SheffieldMLtracking/bee_track_hardware/README.md

# bee_track_hardware
The PCBs and 3d print models etc for the bee tracking system
