SheffieldMLtracking/bee_track_hardware/240625 Freecad formulas box design.rtf

Spreadsheet.Flash_Height * 3 + Spreadsheet.InnerWall_Thickness * 2 + Spreadsheet.TopBottomWall_Thickness * 2
Box height

Spreadsheet.OuterWall_Thickness * 2 + Spreadsheet.Flash_Width * 2 + Spreadsheet.VoltageReg_Width
box width

Spreadsheet.Flash_Depth - Spreadsheet.FrontLid_Thickness + Spreadsheet.HotShoe_Depth
box internal depth (from inside of back wall to front)

Spreadsheet.BackWall_Thickness + Spreadsheet.Flash_Depth - Spreadsheet.FrontLid_Thickness + Spreadsheet.HotShoe_Depth
box depth including back wall

Spreadsheet.BackWall_Thickness + Spreadsheet.Flash_Depth - Spreadsheet.FrontLid_Thickness + Spreadsheet.HotShoe_Depth - 2 * Spreadsheet.FrontPillar_Width - Spreadsheet.BackWall_Thickness
window width

Spreadsheet.True_Flash_Height + Spreadsheet.Flash_Clearance
window height

(Spreadsheet.BackWall_Thickness + Spreadsheet.Flash_Depth - Spreadsheet.FrontLid_Thickness + Spreadsheet.HotShoe_Depth) / 2 - Spreadsheet.FrontPillar_Width
window left edge from centre

(Spreadsheet.True_Flash_Height + Spreadsheet.Flash_Clearance) / 2
middle window top from center

(Spreadsheet.True_Flash_Height + Spreadsheet.Flash_Clearance) / 2 + Spreadsheet.SideWindow_VerticalGapBetweenWindows
top bottom window dist from centre

____________
(Spreadsheet.Flash_Depth - Spreadsheet.FrontLid_Thickness + Spreadsheet.HotShoe_Depth + Spreadsheet.BackWall_Thickness) / 2 - Spreadsheet.FrontPillar_Width / 2
window holes x front

(Spreadsheet.Flash_Depth - Spreadsheet.FrontLid_Thickness + Spreadsheet.HotShoe_Depth + Spreadsheet.BackWall_Thickness) / 2 - Spreadsheet.FrontPillar_Width / 2 - Spreadsheet.BackWall_Thickness
window holes x back

(Spreadsheet.Flash_Height * 3 + Spreadsheet.InnerWall_Thickness * 2) / 2 - 1.5 * Spreadsheet.WindowScrew_Diameter
window holes y top + bottom

___

(Spreadsheet.BackWall_Thickness + Spreadsheet.Flash_Depth - Spreadsheet.FrontLid_Thickness + Spreadsheet.HotShoe_Depth) / 2 - Spreadsheet.BackWall_Thickness + (Spreadsheet.BackWall_Thickness + Spreadsheet.GreenhouseRod_Diameter) / 2
greenhouse rod position

(Spreadsheet.BackWall_Thickness + Spreadsheet.Flash_Depth - Spreadsheet.FrontLid_Thickness + Spreadsheet.HotShoe_Depth) / 2 - Spreadsheet.BackWall_Thickness + (Spreadsheet.BackWall_Thickness / 2 + Spreadsheet.GreenhouseRod_Diameter) / 2 + Spreadsheet.BackWall_Thickness / 2
window screws back holes x

(Spreadsheet.Flash_Height * 3 + Spreadsheet.InnerWall_Thickness * 2 + Spreadsheet.TopBottomWall_Thickness * 2) / 2 - Spreadsheet.TopBottomWall_Thickness - Spreadsheet.CircuitryBox_MountingScrew_Size * 2 - ((Spreadsheet.Flash_Height * 3 + Spreadsheet.InnerWall_Thickness * 2 + Spreadsheet.TopBottomWall_Thickness * 2) / 2 - Spreadsheet.TopBottomWall_Thickness - Spreadsheet.CircuitryBox_MountingScrew_Size * 2 - (Spreadsheet.GreenhouseRod_Offset + Spreadsheet.GreenhouseRod_Diameter)) / 2
window screen back holes y

(Spreadsheet.BackWall_Thickness + Spreadsheet.Flash_Depth - Spreadsheet.FrontLid_Thickness + Spreadsheet.HotShoe_Depth) / 2 - Spreadsheet.BackWall_Thickness + (Spreadsheet.BackWall_Thickness + Spreadsheet.GreenhouseRod_Diameter) / 2
greenhouse rod holes x
______________________
Spreadsheet.BatteryHolder_MountingHole_Width / 2 + 11.5
battery holder front screw x from centre

Spreadsheet.BatteryHolder_MountingHole_Width / 2 + 24
battery holder baCK SCREW X FROM CENTRE

Spreadsheet.BatteryHolder_MountingHole_Height / 2 - 8
BATTERY HOLDER FRONT HOLE Y FROM CENTRE

Spreadsheet.BatteryHolder_MountingHole_Height / 2 - 1
BATTERY HOLDER BACK HOLE Y FROM CENTRE

(Spreadsheet.BackWall_Thickness + Spreadsheet.Flash_Depth - Spreadsheet.FrontLid_Thickness + Spreadsheet.HotShoe_Depth) / 2 - Spreadsheet.LensSlotDepth
lens slot y

(Spreadsheet.OuterWall_Thickness * 2 + Spreadsheet.Flash_Width * 2 + Spreadsheet.VoltageReg_Width) / 2 / 2 - Spreadsheet.LensSlotWidth / 2
lens slot x

__________

top bottom inside wall position

Spreadsheet.GreenhouseRod_Offset - Spreadsheet.GreenhouseRod_Diameter
bottom of rod holder

Spreadsheet.GreenhouseRod_Diameter * 2
height of rod holder

Spreadsheet.GreenhouseRod_Offset + Spreadsheet.GreenhouseRod_Diameter
top of rod holder

_________
(Spreadsheet.Flash_Width * 2 + Spreadsheet.VoltageReg_Width + Spreadsheet.OuterWall_Thickness * 2) / 4 - Spreadsheet.OuterWall_Thickness - Spreadsheet.CircuitryBox_MountingScrew_Size
circuitry box to main box screw holes x
(Spreadsheet.Flash_Height * 3 + Spreadsheet.InnerWall_Thickness * 2 + Spreadsheet.TopBottomWall_Thickness * 2) / 2 - Spreadsheet.TopBottomWall_Thickness - Spreadsheet.CircuitryBox_MountingScrew_Size
circuitry box to main box screw holes y
____________
23.5 / 2 - Spreadsheet.BatteryHolder_LowerPartScrew_Diameter * 1.5 + Spreadsheet.BatteryHolder_LowerPartScrew_Diameter * 1.5
Battholder lower to upper screw hole x

3.5 + Spreadsheet.BatteryHolder_LowerPartScrew_Diameter * 1.5
Battholder lower to upper left screw hole y

33 + Spreadsheet.BatteryHolder_LowerPartScrew_Diameter * 1.5
Battholder lower to upper right screw hole y

__________
(Spreadsheet.OuterWall_Thickness * 2 + Spreadsheet.Flash_Width * 2 + Spreadsheet.VoltageReg_Width) / 2 - Spreadsheet.OuterWall_Thickness - Spreadsheet.CircuitryBox_Lid_Margins
back lid holes x

(Spreadsheet.Flash_Height * 3 + Spreadsheet.InnerWall_Thickness * 2 + Spreadsheet.TopBottomWall_Thickness * 2) / 2 - Spreadsheet.TopBottomWall_Thickness - Spreadsheet.CircuitryBox_Lid_Margins / 2
back lid holes y

((Spreadsheet.OuterWall_Thickness * 2 + Spreadsheet.Flash_Width * 2 + Spreadsheet.VoltageReg_Width) / 2 - Spreadsheet.OuterWall_Thickness) - ((Spreadsheet.OuterWall_Thickness * 2 + Spreadsheet.Flash_Width * 2 + Spreadsheet.VoltageReg_Width) / 4)
circuit box inner wall surface xpos

(Spreadsheet.InnerWall_Thickness * 2 + Spreadsheet.Flash_Height * 3) / 2
circuit box inner wall surface ypos

(Spreadsheet.OuterWall_Thickness * 2 + Spreadsheet.Flash_Width * 2 + Spreadsheet.VoltageReg_Width) / 2 / 2 - Spreadsheet.OuterWall_Thickness - Spreadsheet.CircuitryBox_Lid_Margins
curcuit box lid holes x

(Spreadsheet.Flash_Height * 3 + Spreadsheet.InnerWall_Thickness * 2 + Spreadsheet.TopBottomWall_Thickness * 2) / 2 - Spreadsheet.TopBottomWall_Thickness - Spreadsheet.CircuitryBox_Lid_Margins / 2
circuit box lid holes y

((Spreadsheet.OuterWall_Thickness * 2 + Spreadsheet.Flash_Width * 2 + Spreadsheet.VoltageReg_Width) / 2 - Spreadsheet.OuterWall_Thickness - (Spreadsheet.OuterWall_Thickness * 2 + Spreadsheet.Flash_Width * 2 + Spreadsheet.VoltageReg_Width) / 4 - ((Spreadsheet.OuterWall_Thickness * 2 + Spreadsheet.Flash_Width * 2 + Spreadsheet.VoltageReg_Width) / 2 / 2 - Spreadsheet.OuterWall_Thickness - Spreadsheet.CircuitryBox_Lid_Margins)) * 2
cbox pad for lid nut inset width

((Spreadsheet.InnerWall_Thickness * 2 + Spreadsheet.Flash_Height * 3) / 2 - ((Spreadsheet.Flash_Height * 3 + Spreadsheet.InnerWall_Thickness * 2 + Spreadsheet.TopBottomWall_Thickness * 2) / 2 - Spreadsheet.TopBottomWall_Thickness - Spreadsheet.CircuitryBox_Lid_Margins / 2)) * 2
cbox pad for lid ut inset height

_________
(Spreadsheet.OuterWall_Thickness * 2 + Spreadsheet.Flash_Width * 2 + Spreadsheet.VoltageReg_Width) / 4
cbox box centre from datum centre x

(Spreadsheet.OuterWall_Thickness * 2 + Spreadsheet.Flash_Width * 2 + Spreadsheet.VoltageReg_Width) / 2 - Spreadsheet.OuterWall_Thickness - Spreadsheet.CircuitryBox_Lid_Margins
cbox back curved cut out width

(Spreadsheet.InnerWall_Thickness * 2 + Spreadsheet.Flash_Height * 3) / 2 - Spreadsheet.CircuitryBox_Lid_Margins
cbox back curved cut out top edge fromn centree= of datum y

Spreadsheet.InnerWall_Thickness * 2 + Spreadsheet.Flash_Height * 3 - Spreadsheet.CircuitryBox_Lid_Margins * 2
cbox back curved cutout height

((Spreadsheet.OuterWall_Thickness * 2 + Spreadsheet.Flash_Width * 2 + Spreadsheet.VoltageReg_Width) / 4) + ((Spreadsheet.Flash_Width * 2 + Spreadsheet.VoltageReg_Width + Spreadsheet.OuterWall_Thickness * 2) / 4 - Spreadsheet.OuterWall_Thickness - Spreadsheet.CircuitryBox_MountingScrew_Size)

Spreadsheet.CircuitryBox_Depth / 2 - Spreadsheet.CircuitryBox_Wall_Thickness * 2
CBOX VENT X

Spreadsheet.CircuitryBox_Depth - Spreadsheet.CircuitryBox_Wall_Thickness * 4
cbox vent width

(Spreadsheet.VentHeight + Spreadsheet.VentSeparation) * Spreadsheet.VentYConverter
cbox y dist between tops opf vents
