SheffieldMLtracking/bee_track_hardware/components.md

## Camera
(need 1 or 2 per unit)
<https://shop.scorpion.vision/products/3-2mp-1-1-8-imx265-gige-monochrome-camera-1>
Either greyscale or both greyscale & colour.
Stock: ordered 10 colour; 15 greyscale.

## Lens
(need 1 or 2 per unit)
Stock: ordered 25 6mm.

## Hirose Connector [done - TODO!]
(need 1/2 per unit)
Hirose 6 Pin to 6 Pin Power Cable for Basler CCD AVT Industrial Camera(Straight-Straight, 1M) [ HR10A-7P-6S ]
<https://www.amazon.co.uk/dp/B07YCBNQH2?psc=1&ref=ppx_yo2ov_dt_b_product_details>
Stock: ordered 1 cable (2 systems). TODO Order more!!

## Ethernet cable [done]
(need 1 to 3 per unit)
Previously <https://www.amazon.co.uk/gp/product/B01LF83EZS/ref=ppx_yo_dt_b_search_asin_title?ie=UTF8&psc=1>
Now: <https://uk.farnell.com/pro-signal/psg03118/cat5-lead-0-2m-black/dp/3498229?st=ethernet%20cable>
Stock: Ordered 5 (check they are suitable). (enough for 5 greyscale units)

## Switch / Splitter [done]
(need 0 or 1 per unit -- only needed if colour camera)
Trying out <https://www.amazon.co.uk/gp/product/B0CR6C4Y4H/ref=ox_sc_act_title_1?smid=AOI3HFK8F8ZMZ&psc=1>
Stock: Ordered 1. 

## Contact Spring (for batteries) [done]
(need 4 per unit)
<https://uk.farnell.com/harwin/s7091-42r/contact-spring-smt-2-7mm/dp/2211307?st=spring>
Stock: ordered 12 (3 systems) TODO make 20.
Notes: uses a 2M bolt, nuts and washers.

## Wire [skip]
unit will need about 350mm long black/red figure-8-pair-cable
Stock: Available.

## Fake AA Battery Crimps [done]
(need 2xnumber of flashes per unit, so 8-16 per unit)
Will use these at end of battery to make contact.
Crimps list of possible products <https://uk.farnell.com/w/c/connectors/crimp-terminals-solder-terminals-splices/ring-crimp-terminals/prl/results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|m2.5|m3&range=inc-in-stock|exc-obs|inc-in-stock%7Cexc-obs&sort=P_PRICE>
Ordered these: <https://uk.farnell.com/jst-japan-solderless-terminals/lrb-2-5t-m3/crimp-terminal-ring-m3/dp/7356560>
Need a crimp tool (video <https://www.youtube.com/watch?v=bODeHs6InPw>)
Stock: ordered 100 (for 6 units)

## Raspberry Pi [done]
(need 1 per unit)
<https://shop.pimoroni.com/products/raspberry-pi-5?variant=41044580171859>
Stock: Ordered 5 (for 5 units)

## SD-card [done]
(need 1 per unit)
E.g. 256Gb V30 U3.
<https://www.amazon.co.uk/dp/B08XWT6Q9G?psc=1&ref=ppx_yo2ov_dt_b_product_details>
Stock: Ordered 5 (for 5 units)

## Flash
(need 4-8 per unit)
<https://www.lencarta.com/neewer-tt560-speedlite-flash-for-dslr-cameras>
Ordered: In progress, ordering 50 (for 6 units)

## 12V to 5V Buck Converter [done]
Need 2-4 per unit.
<https://www.amazon.co.uk/dp/B09PTTVXV2>
Ordered: 16. (for 4 units)

## <st>UBEC Skip</st>
<st>For example <https://www.ebay.co.uk/itm/295852158570></st>
Will just use the buck converter.

## Rocker Switches [skip]
(need 2 per unit)
<https://www.amazon.co.uk/dp/B0825W4GGH?ref_=pe_27063361_487360311_302_E_DDE_dt_1>
Ordered: Already have a few?

## Bolt For Tripod
To Do

## More Nuts and Bolts
To Do

## External Power Supply Regulator
Order 6 of these <https://www.amazon.co.uk/dp/B0823DB3W3?psc=1&smid=AFNZSIWHYJJRZ&ref_=chk_typ_imgToDp>.

## External Power Socket
Ordered 15.
<https://www.amazon.co.uk/dp/B0CH7WX85X>

## Field Trial External Batteries
To Do

## 3.5mm right-angle connectors
Ordered these <https://www.ebay.co.uk/itm/183758840967> (12 ordered = 24 connectors, 6 needed per unit, so 4 units).

## Washers for hotshoes [done]
This might not be the design afterall!
20mm outside, M4.
zinc plated steel
<https://www.bolts.co.uk/m4-x-20mm-repair-penny-washer-bzp-pack-of-500-p-FWRMZP04020/>
