SheffieldMLtracking/bee_track_hardware/PCB/power/BOM_PCBWay.xlsx

 |  |  | xxxx xxxx xxxxx xxPCS BOM (Sample Bill of Materials)
Item # | *Designator | *Qty | Manufacturer | *Mfg Part # | Description / Value | *Package/Footprint | Type | Your Instructions / Notes
1 | J1,J2,J3,J4,J5,J6,J7 | 7 | CAMDENBOSS | CTB5202/4 | Standard Terminal Block, Wire to Board, CTB5202, 4 Contacts, 5 mm, Terminal Block, PCB, PCB Mount | 5mm pitch, 4 pins | thru-hole | Please place with holes facing OUTWARDS. | https://uk.farnell.com/camdenboss/ctb5202-4/terminal-block-wire-to-brd-4pos/dp/1717003
