SheffieldMLtracking/bee_track_hardware/PCB/pi_hat/PCBWay_BOM.xlsx

 |  |  | xxxx xxxx xxxxx xxPCS BOM (Sample Bill of Materials)
Item # | *Designator | *Qty | Manufacturer | *Mfg Part # | Description / Value | *Package/Footprint | Type | Your Instructions / Notes
1 | C1 | 1 | MURATA | GRM155R61E105KA12J | SMD Multilayer Ceramic Capacitor 1uF | 0402 [1005 metric] SMD | SMD |  | https://uk.farnell.com/murata/grm155r61e105ka12j/cap-1uf-25v-mlcc-0402/dp/3790417
2 | C2,C3,C4,C6,C7 | 5 | WALSIN | 0402X104K250CT | SMD Multilayer Ceramic Capacitor 0.1uF | 0402 [1005 metric] SMD | SMD |  | https://uk.farnell.com/walsin/0402x104k250ct/cap-0-1-f-25v-10-x5r-0402/dp/2496811
3 | C5 | 1 | KEMET | EDK106M035A9BAA | SMD Aluminium Electrolytic Capacitor, Radial Can. 10 µF. | SMD | SMD | Positive indicated with + | https://uk.farnell.com/kemet/edk106m035a9baa/cap-10uf-35v-alu-elec-smd/dp/4144058
4 | J1,J2,J4,J5,J6,J7,J8,J9 | 8 | CAMDENBOSS | CTB5202/4 | Standard Terminal Block, Wire to Board, CTB5202, 4 Contacts, 5 mm, Terminal Block, PCB, PCB Mount | 5mm pitch, 4 pins | thru-hole | Please place with holes facing OUTWARDS. | https://uk.farnell.com/camdenboss/ctb5202-4/terminal-block-wire-to-brd-4pos/dp/1717003
5 | J3 | 1 | WURTH ELEKTRONIK | 61304021821 | socket header; 2.54 pitch; 20 x 2 rows. | 40 contacts [20 x 2]; 2.54mm pitch | thru-hole | Symmetric (so orientation doesn’t matter) | https://uk.farnell.com/wurth-elektronik/61304021821/connector-rcpt-40pos-2row-2-54mm/dp/2827916
6 | Q1,Q2,Q3,Q4,Q5,Q6,Q7,Q8 | 8 | Multicomp Pro | BC549C | NPN Transistors | TO-92 | thru-hole | Flat side towards edge of PCB, indicated in silk-screen (collector on left) | https://uk.farnell.com/multicomp/bc549c/transistor-npn-30v-to-92/dp/1574382?ost=1574382
7 | R1,R3,R5 | 3 | Multicomp Pro | MCWR04X3303FTL | SMD Chip Resistor, 330K | 0402 [1005 metric] SMD | SMD |  | https://uk.farnell.com/multicomp/mcwr04x3303ftl/res-330k-1-0-0625w-thick-film/dp/2447158
8 | R2,R4,R6 | 3 | Multicomp Pro | MCWR04X5602FTL | SMD Chip Resistor, 56K | 0402 [1005 metric] SMD | SMD |  | https://uk.farnell.com/multicomp/mcwr04x5602ftl/res-56k-1-0-0625w-thick-film/dp/2447198
9 | R9,R10,R11,R12,R13,R14,R15,R16 | 8 | Multicomp Pro | MCWR04X5600FTL | SMD Chip Resistor, 560R | 0402 [1005 metric] SMD | SMD |  | https://uk.farnell.com/multicomp/mcwr04x5600ftl/res-560r-1-0-0625w-thick-film/dp/2447197
10 | U1,U2 | 2 | NEXPERIA | 74AHC08PW-Q100J | 7408 Quad 2-input AND. | 14 pin TSSOP | SMD | Pin 1 indicated by line by pad, and a circle (bottom right) | https://uk.farnell.com/nexperia/74ahc08pw-q100j/and-gate-aec-q100-2-i-p-40to125deg/dp/3441595
11 | U3 | 1 | MICROCHIP | MCP3008-I/SL | Analogue to Digital Converter, Octal, 10 bit. | 16 pin SOIC | SMD | Pin 1 indicated by line next to pad (top left) | https://uk.farnell.com/microchip/mcp3008-i-sl/10bit-adc-8-ch-spi-smd-soic16/dp/1292241?st=mcp3008
12 | U4 | 1 | MICROCHIP | MCP1541T-I/TT | Voltage Reference (4.096V), MCP1541 | SOT-23-3 | SMD | Pin 1 indicated by line next to pad (top left) | https://uk.farnell.com/microchip/mcp1541t-i-tt/voltage-ref-series-4-096v-sot/dp/1084310?st=mcp1541
 |  |  |  |  |  |  |  | All components placed on top side
