SheffieldMLtracking/bee_track_hardware/FreeCAD design files/Exported Step files for each component/Main body #001 (Right).step

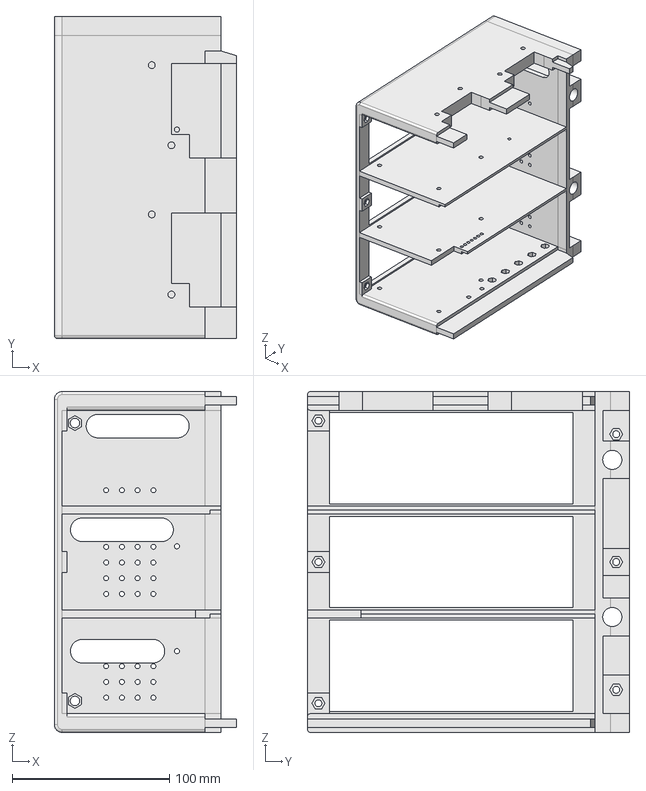
[picture p1: CAD file, 2024-08-01]
FreeCAD design files/Exported Step files for each component/Main body #001 (Right).step
116.0 x 205.0 x 217.0 mm
