SheffieldMLtracking/bee_track_hardware/FreeCAD design files/AABattery (Joe most recent version 2406716).FCStd

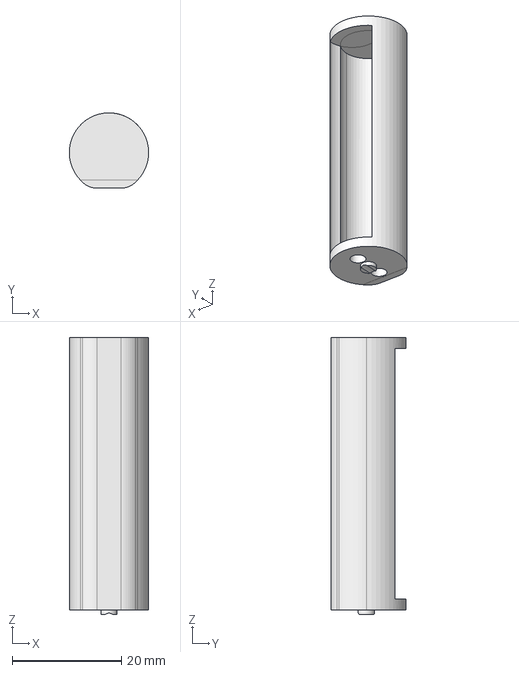
[picture p3: CAD file, 2024-08-01]
FreeCAD design files/AABattery (Joe most recent version 2406716).FCStd
14.5 x 13.7 x 50.6 mm
