SheffieldMLtracking/bee_track_hardware/FreeCAD design files/Exported Step files for each component/Side cover #002 (Left).step

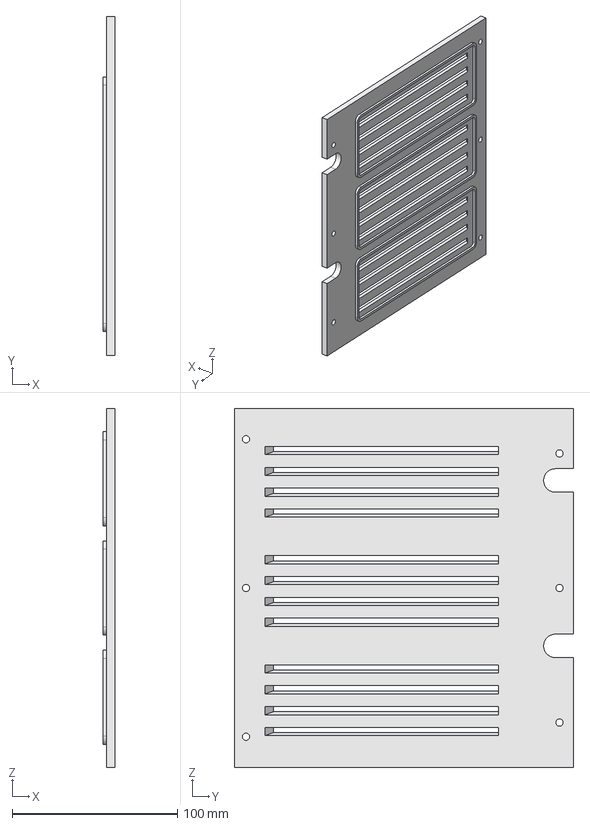
[picture p4: CAD file, 2024-08-01]
FreeCAD design files/Exported Step files for each component/Side cover #002 (Left).step
7.00 x 205.0 x 217.0 mm
