SheffieldMLtracking/bee_track_hardware/markingpots.FCStd

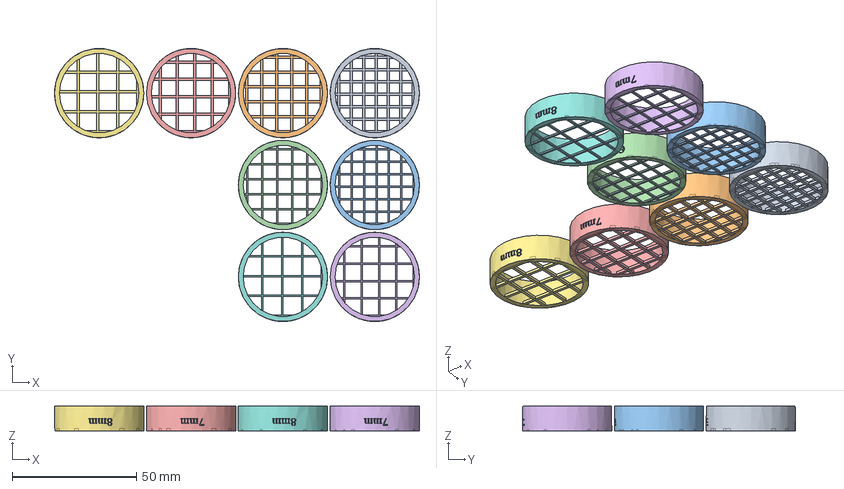
[picture p5: CAD file, 2024-07-18]
markingpots.FCStd
147.0 x 110.0 x 10.0 mm
5mm
6mm
5mm001
6mm001
7mm
7mm001
8mm
8mm001
