SheffieldMLtracking/bee_track_hardware/PCB/pi_hat/BC849CLT1G/3D/BC849CLT1G.stp

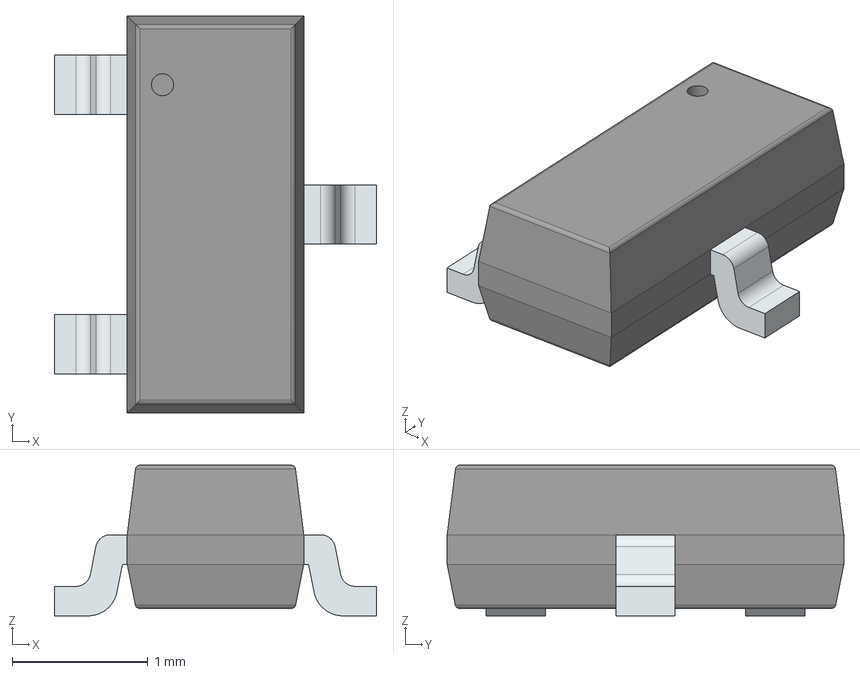
[picture p6: CAD file, 2024-04-17]
PCB/pi_hat/BC849CLT1G/3D/BC849CLT1G.stp
2.37 x 2.92 x 1.11 mm
PinsArrayL
FilletPinR
