SheffieldMLtracking/bee_track_hardware/FreeCAD design files/Exported Step files for each component/Circuit box.step

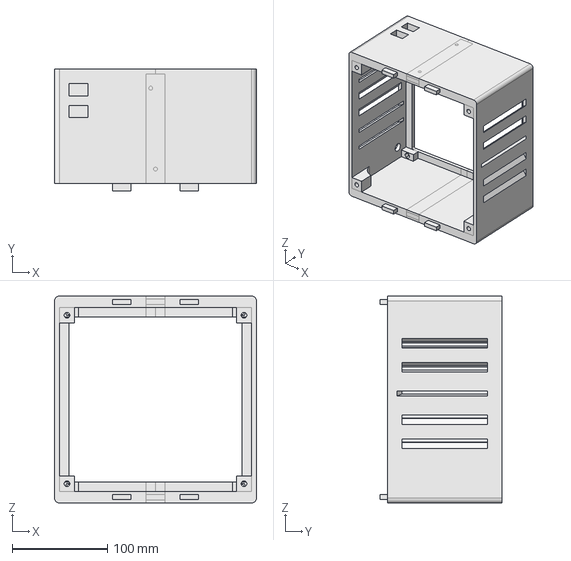
[picture p7: CAD file, 2024-08-01]
FreeCAD design files/Exported Step files for each component/Circuit box.step
212.0 x 127.8 x 217.0 mm
