SheffieldMLtracking/bee_track_hardware/FreeCAD design files/AABattery (Mike version).FCStd

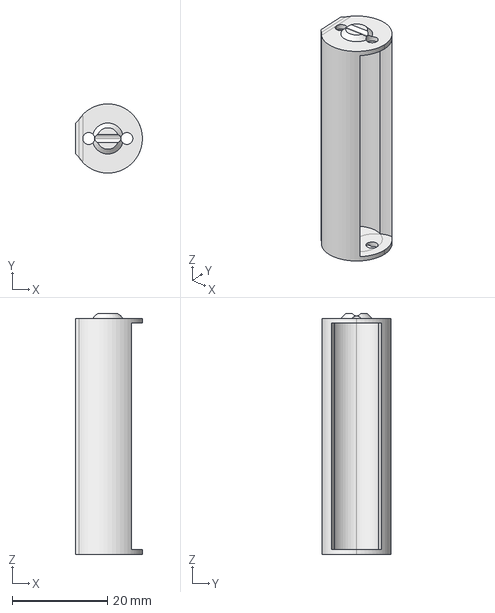
[picture p8: CAD file, 2024-06-29]
FreeCAD design files/AABattery (Mike version).FCStd
14.0 x 14.5 x 50.5 mm
