SheffieldMLtracking/bee_track_hardware/FreeCAD design files/Exported Step files for each component/Tripod mount.step

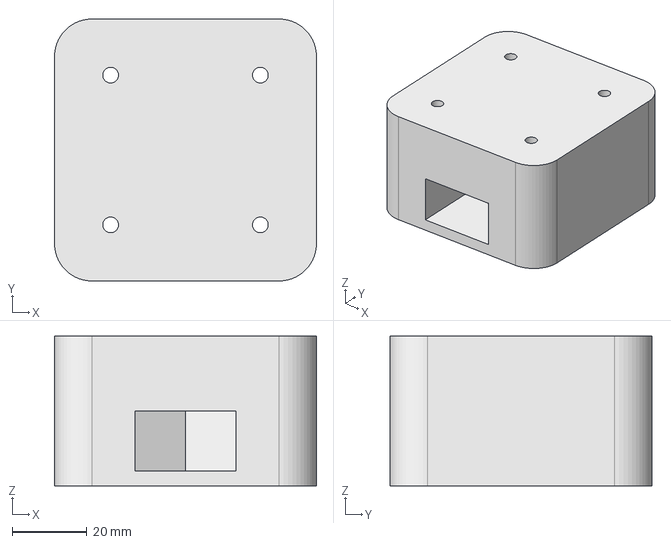
[picture p9: CAD file, 2024-08-01]
FreeCAD design files/Exported Step files for each component/Tripod mount.step
70.0 x 70.0 x 40.0 mm
