SheffieldMLtracking/bee_track_hardware/FreeCAD design files/Exported Step files for each component/Camera mount.step

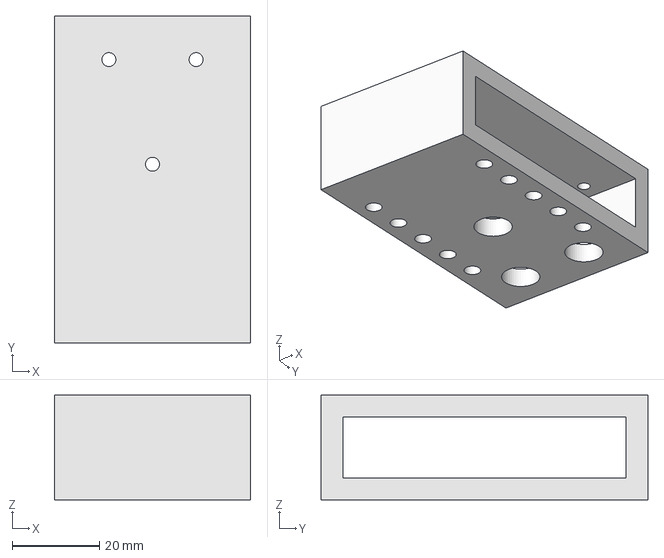
[picture p10: CAD file, 2024-08-01]
FreeCAD design files/Exported Step files for each component/Camera mount.step
45.0 x 75.0 x 24.0 mm
