SheffieldMLtracking/bee_track_hardware/FreeCAD design files/Exported Step files for each component/Back cover.step

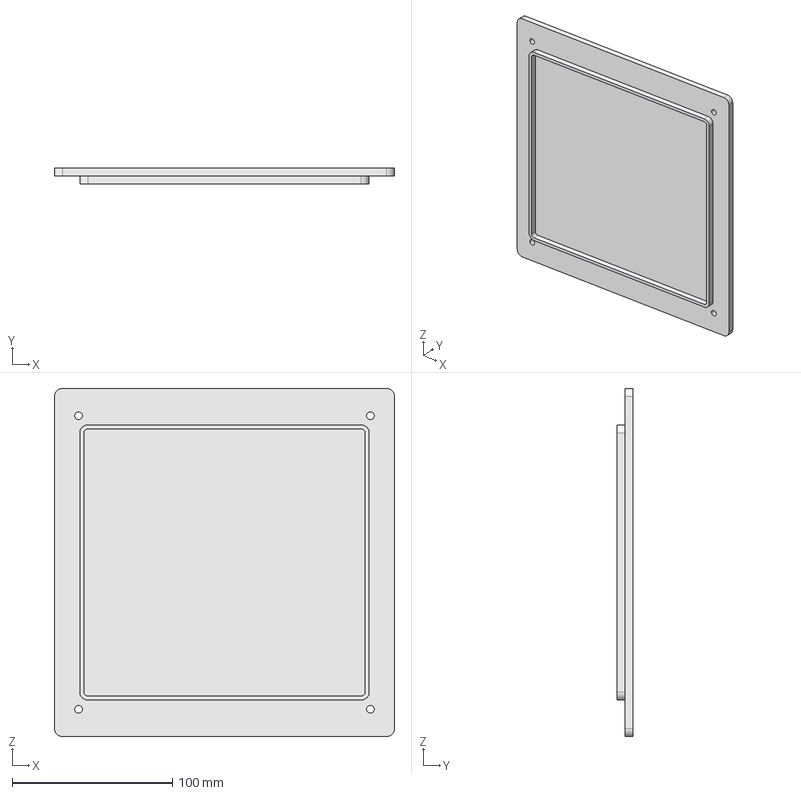
[picture p11: CAD file, 2024-08-01]
FreeCAD design files/Exported Step files for each component/Back cover.step
212.0 x 10.0 x 217.0 mm
