SheffieldMLtracking/bee_track_hardware/FreeCAD design files/Exported Step files for each component/Battery holder #001 (Top).step

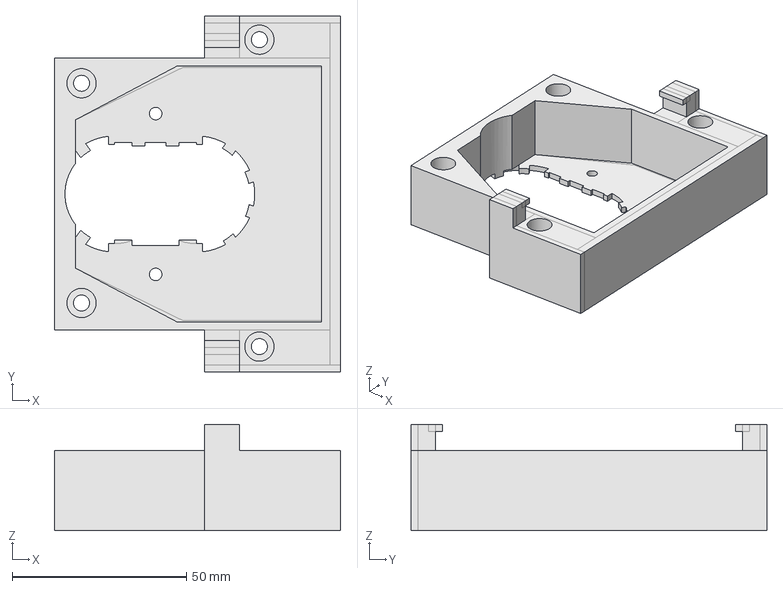
[picture p12: CAD file, 2024-08-01]
FreeCAD design files/Exported Step files for each component/Battery holder #001 (Top).step
82.0 x 102.0 x 30.5 mm
