SheffieldMLtracking/bee_track_hardware/FreeCAD design files/Exported Step files for each component/Battery holder #002 (Bottom).step

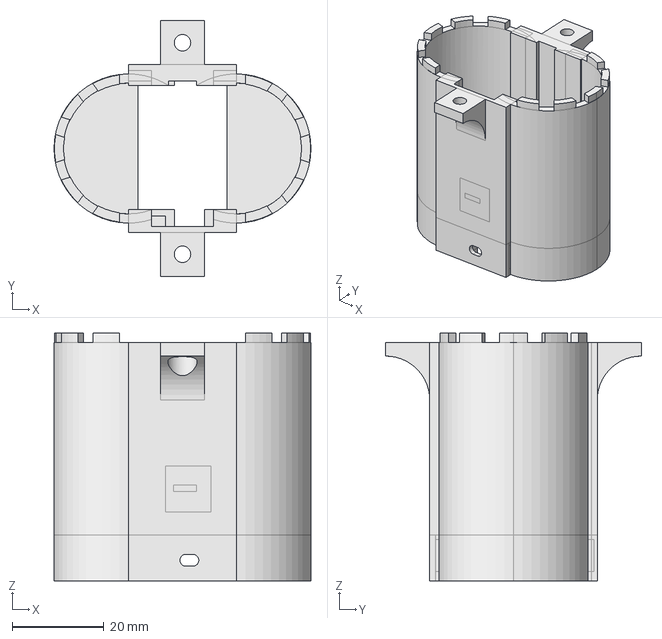
[picture p13: CAD file, 2024-08-01]
FreeCAD design files/Exported Step files for each component/Battery holder #002 (Bottom).step
56.0 x 55.7 x 54.0 mm
