SheffieldMLtracking/bee_track_hardware/OrcaSlicer project files/240716 Main box #002.3mf

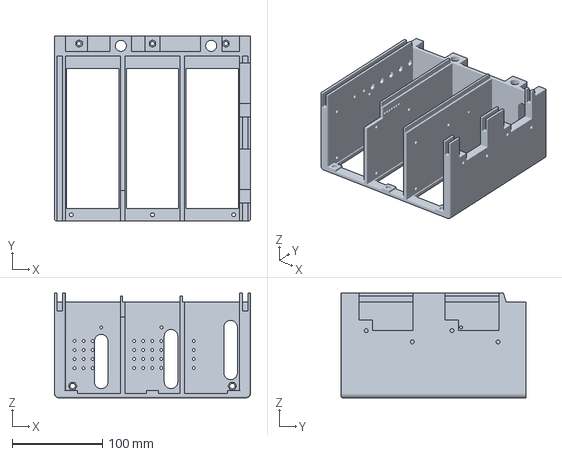
[picture p14: CAD file, 2024-08-01]
OrcaSlicer project files/240716 Main box #002.3mf
217.0 x 205.0 x 116.0 mm
