SheffieldMLtracking/bee_track_hardware/(list of files, cad)

Other CAD files:
FreeCAD design files/RetroreflectorCaseTopology (Joe most recent version 240801).FCStd
FreeCAD design files/Exported Step files for each component/Side cover #001 (Right).step
FreeCAD design files/Exported Step files for each component/AA Battery.step
OrcaSlicer project files/240716 Main box #001.3mf
FreeCAD design files/Exported Step files for each component/Bottom piece (unused).step
OrcaSlicer project files/240712 Back cover.3mf
OrcaSlicer project files/240712 Side cover #001.3mf
OrcaSlicer project files/240716 Battery stuff for half a box.3mf
OrcaSlicer project files/240716 Circuit box.3mf
OrcaSlicer project files/240726 Camera and tripod mounts.3mf
OrcaSlicer project files/240801 All small components for 1 box.3mf
PCB/pi_hat/BC849CLT1G/Allegro/sot96p237x111-3n.psm
PCB/pi_hat/BC849CLT1G/DEHDL/bc849clt1g/chips/chips.prt
