SheffieldMLtracking/bee_track_hardware/(threads)

Thread 1 (2024-05-28):

PCB layout error

lionfish0, 2024-05-28:
The AtoD isn't going to work in "Apr 2024" PCB version:
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
the pinouts are wrong: Got pin 3 and 1 swapped - pin 3 goes to 5V instead of GND. pin 1 goes to GND instead of 5V. pin 2 I think is correctly connected?

The AtoD isn't essential for the project.

Thread 3 (2024-06-29):

AA Fake Batteries

lionfish0, 2024-06-29:
The old batteries are [here](https://github.com/SheffieldMLtracking/bee_track_hardware/blob/main/aabattery.FCStd), but these used a bit of wire twisted through the holes etc. The plan was for the new ones to use [these crimps](https://uk.farnell.com/jst-japan-solderless-terminals/lrb-2-5t-m3/crimp-terminal-ring-m3/dp/7356560) on the batteries - as that means zero soldering.

Two things:

1. I've not designed a new CAD model to accommodate this crimp design.
2. Just to note: Each flash only needs two fake-batteries, and each only needs a contact at ONE end (either the positive end or negative -- see in the old boxes for an example).
