SheffieldMLtracking/bee_track_hardware/PCB/power/pcb.kicad_pcb

## KiCad design PCB/power/pcb.kicad_pcb (2024-04-17)

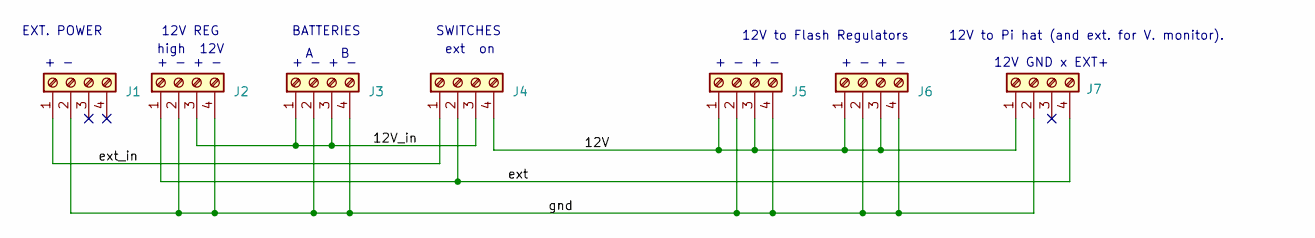
[picture p15: schematic pcb.kicad_sch]

Parts:
J1, J2, J3, J4, J5, J6, J7: Screw_Terminal_01x04; TerminalBlock_RND_205-00278_1x04_P5.00mm_Vertical

Connections:
/12V: J4.4, J5.1, J5.3, J6.1, J6.3, J7.1
/12V_in: J2.3, J3.1, J3.3, J4.3
/ext: J2.1, J4.2, J7.4
/ext_in: J1.1, J4.1
/gnd: J1.2, J2.2, J2.4, J3.2, J3.4, J5.2, J5.4, J6.2, J6.4, J7.2

Notes on the sheet:
high 12V
12V to Flash Regulators
12V REG
+ - + -
BATTERIES
12V to Pi hat (and ext. for V. monitor).
A B
12V GND x EXT+
EXT. POWER
ext on
+ -
SWITCHES

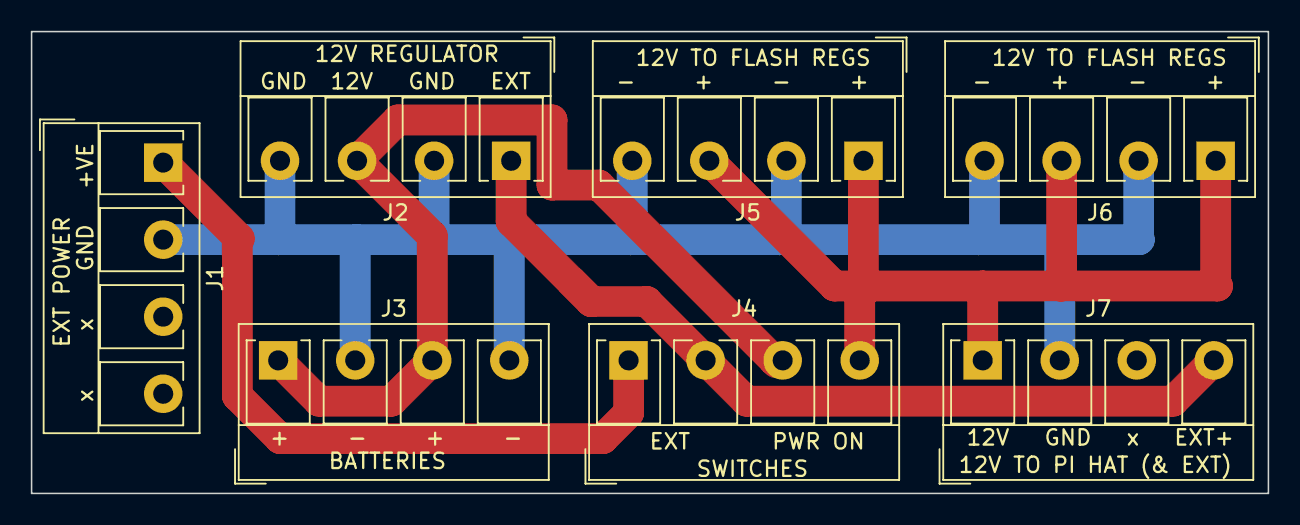
[picture p16: board PCB/power/pcb.kicad_pcb from above]

Board: 2 copper layers, 80.3 x 30.0 mm, 7 parts (0 on the bottom side), 5 nets.
