SheffieldMLtracking/bee_track_hardware/PCB/pi_hat/pcb.kicad_pcb

## KiCad design PCB/pi_hat/pcb.kicad_pcb (2024-04-17)

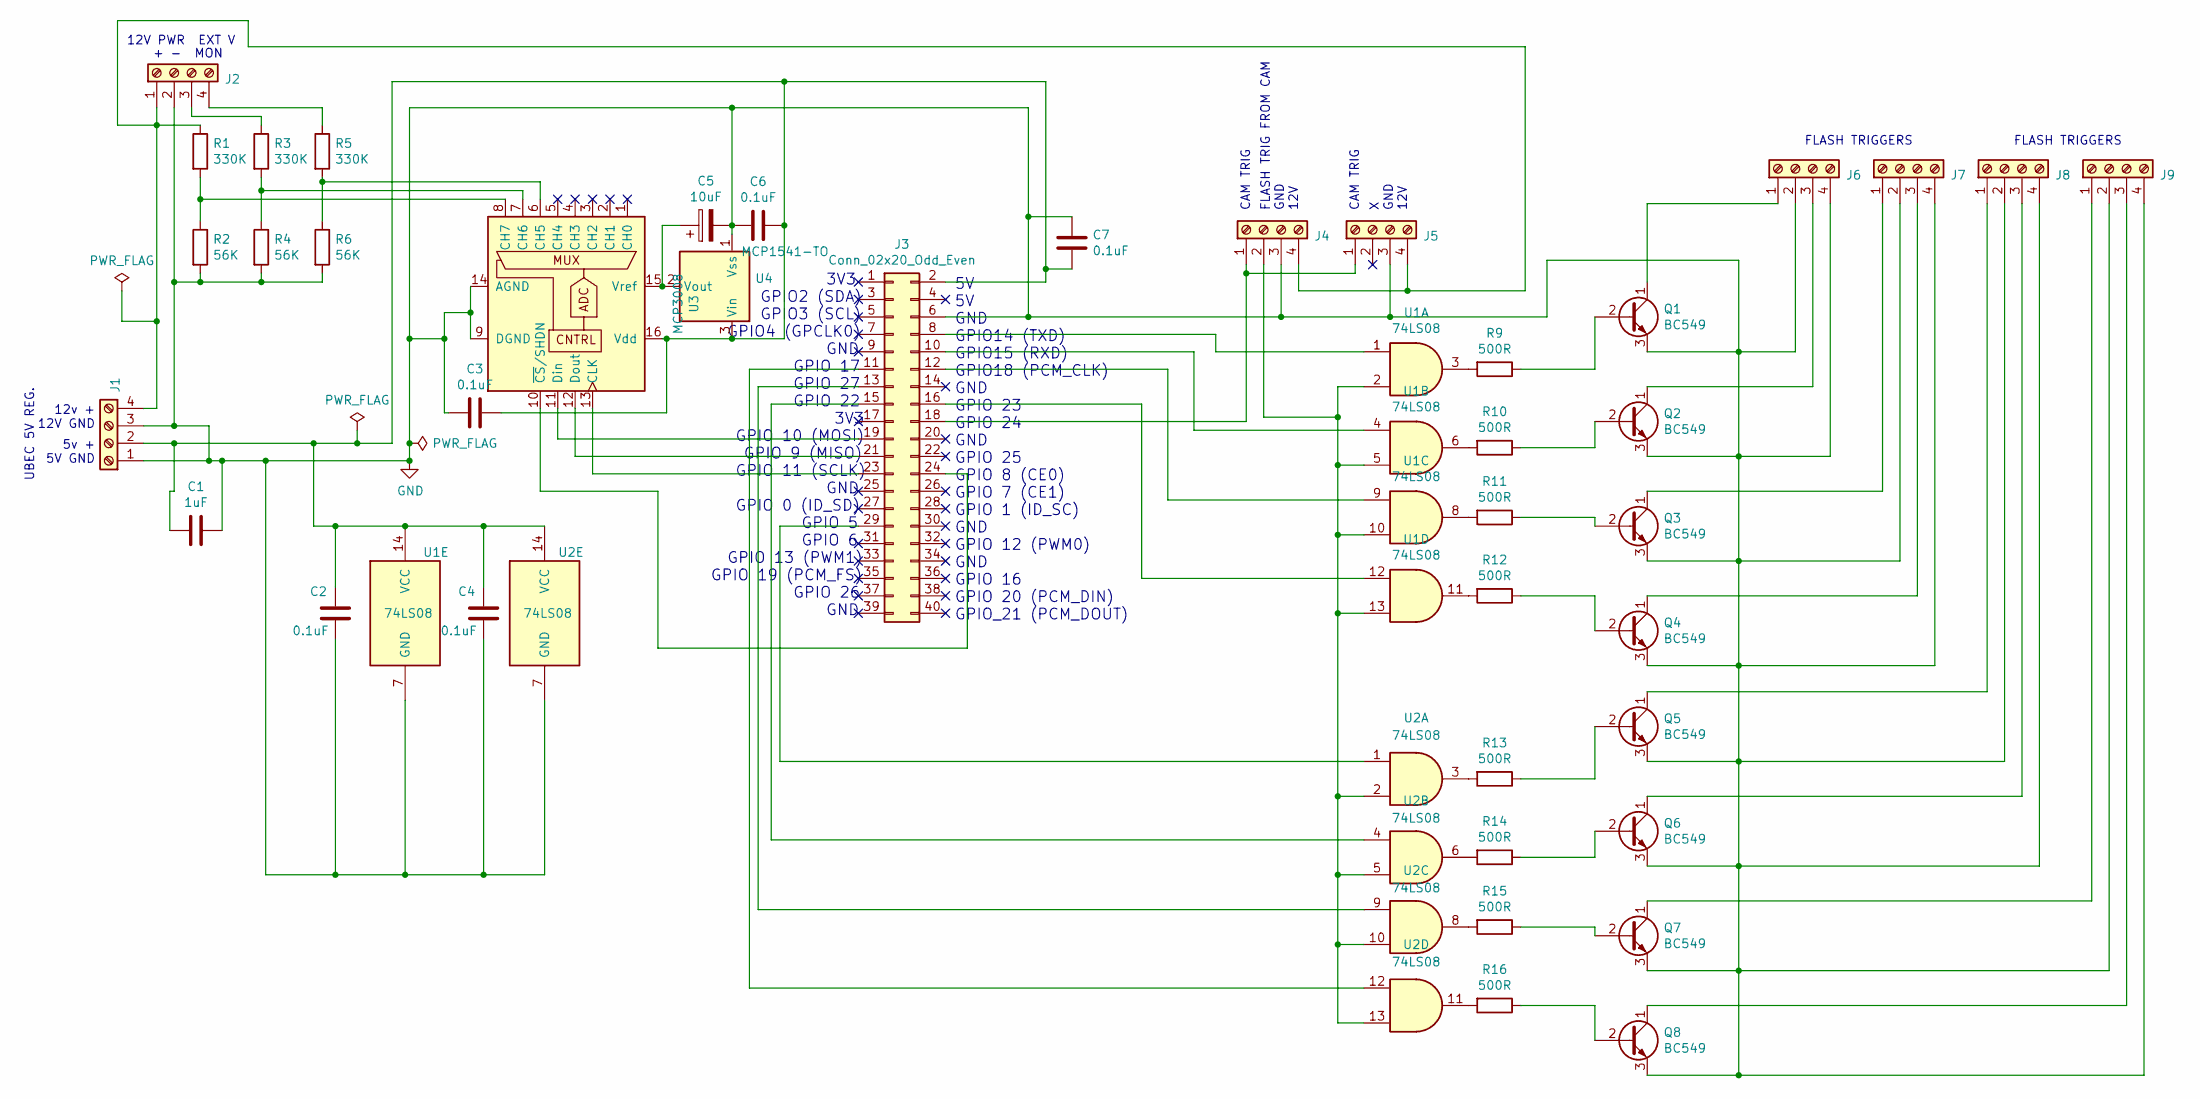
[picture p17: schematic pcb.kicad_sch]

Parts:
C1: 1uF; C_0402_1005Metric
C2, C3, C4, C6, C7: 0.1uF; C_0402_1005Metric
C5: 10uF; CP_Elec_4x5.4
J1, J2, J4, J5, J6, J7, J8, J9: Screw_Terminal_01x04; TerminalBlock_RND_205-00278_1x04_P5.00mm_Vertical
J3: Conn_02x20_Odd_Even; Flipped_IDC
Q1, Q2, Q3, Q4, Q5, Q6, Q7, Q8: BC549; TO-92_Inline
R1, R3, R5: 330K; R_0402_1005Metric
R2, R4, R6: 56K; R_0402_1005Metric
R9, R10, R11, R12, R13, R14, R15, R16: 500R; R_0402_1005Metric
U1, U2: 74LS08; TSSOP-14_4.4x5mm_P0.65mm
U3: MCP3008; SOIC127P600X175-16N
U4: MCP1541-TO; SOT-23-3

Connections:
GND: C1.1, C2.2, C3.2, C4.2, C5.2, C6.2, C7.1, J1.1, J1.3, J2.2, J3.6, J4.3, J5.3, J6.2, J6.4, J7.2, J7.4, J8.2, J8.4, J9.2, J9.4, Q1.3 (E), Q2.3 (E), Q3.3 (E), Q4.3 (E), Q5.3 (E), Q6.3 (E), Q7.3 (E), Q8.3 (E), R2.2, R4.2, R6.2, U1.7 (GND), U2.7 (GND), U3.9 (DGND), U3.14 (AGND), U4.1 (Vss)
unnamed: C1.2, C2.1, C3.1, C4.1, C6.1, C7.2, J1.2, J3.2, U1.14 (VCC), U2.14 (VCC), U3.16 (Vdd), U4.3 (Vin)
unnamed: J1.4, J2.1, J4.4, J5.4, R1.1
unnamed: J2.3, R3.1
unnamed: J2.4, R5.1
unnamed: J3.8, U1.1
unnamed: J3.10, U1.4
unnamed: J3.11, U2.12
unnamed: J3.12, U1.9
unnamed: J3.13, U2.9
unnamed: J3.15, U2.4
unnamed: J3.16, U1.12
unnamed: J3.18, J4.1, J5.1
unnamed: J3.19, U3.11 (Din)
unnamed: J3.21, U3.12 (Dout)
unnamed: J3.23, U3.13 (CLK)
unnamed: J3.24, U3.10 (~CS/SHDN)
unnamed: J3.29, U2.1
unnamed: J4.2, U1.2, U1.5, U1.10, U1.13, U2.2, U2.5, U2.10, U2.13
unnamed: J6.1, Q1.1 (C)
unnamed: J6.3, Q2.1 (C)
unnamed: J7.1, Q3.1 (C)
unnamed: J7.3, Q4.1 (C)
unnamed: J8.1, Q5.1 (C)
unnamed: J8.3, Q6.1 (C)
unnamed: J9.1, Q7.1 (C)
unnamed: J9.3, Q8.1 (C)
unnamed: Q1.2 (B), R9.1
unnamed: Q2.2 (B), R10.1
unnamed: Q3.2 (B), R11.1
unnamed: Q4.2 (B), R12.1
unnamed: Q5.2 (B), R13.1
unnamed: Q6.2 (B), R14.1
unnamed: Q7.2 (B), R15.1
unnamed: Q8.2 (B), R16.1
unnamed: R9.2, U1.3
unnamed: R10.2, U1.6
unnamed: R11.2, U1.8
unnamed: R12.2, U1.11
unnamed: R13.2, U2.3
unnamed: R14.2, U2.6
unnamed: R15.2, U2.8
unnamed: R16.2, U2.11
unnamed: R5.2, R6.1, U3.6 (CH5)
unnamed: R3.2, R4.1, U3.7 (CH6)
unnamed: R1.2, R2.1, U3.8 (CH7)
unnamed: C5.1, U3.15 (Vref), U4.2 (Vout)

Notes on the sheet:
FLASH TRIGGERS
+ - MON
5V 5V GND GPIO14 (TXD) GPIO15 (RXD) GPIO18 (PCM_CLK) GND GPIO 23 GPIO 24 GND GPIO 25 GPIO 8 (CE0) GPIO 7 (CE1) GPIO 1 (ID_SC) GND GPIO 12 (PWM0) GND GPIO 16 GPIO 20 (PCM_DIN) GPIO_21 (PCM_DOUT)
5v + 5V GND
X GND 12V
3V3 GPIO2 (SDA) GPIO3 (SCL) GPIO4 (GPCLK0) GND GPIO 17 GPIO 27 GPIO 22 3V3 GPIO 10 (MOSI) GPIO 9 (MISO) GPIO 11 (SCLK) GND GPIO 0 (ID_SD) GPIO 5 GPIO 6 GPIO 13 (PWM1) GPIO 19 (PCM_FS) GPIO 26 GND
FLASH TRIG FROM CAM GND 12V
UBEC 5V REG.
CAM TRIG
12V PWR EXT V
12v + 12V GND

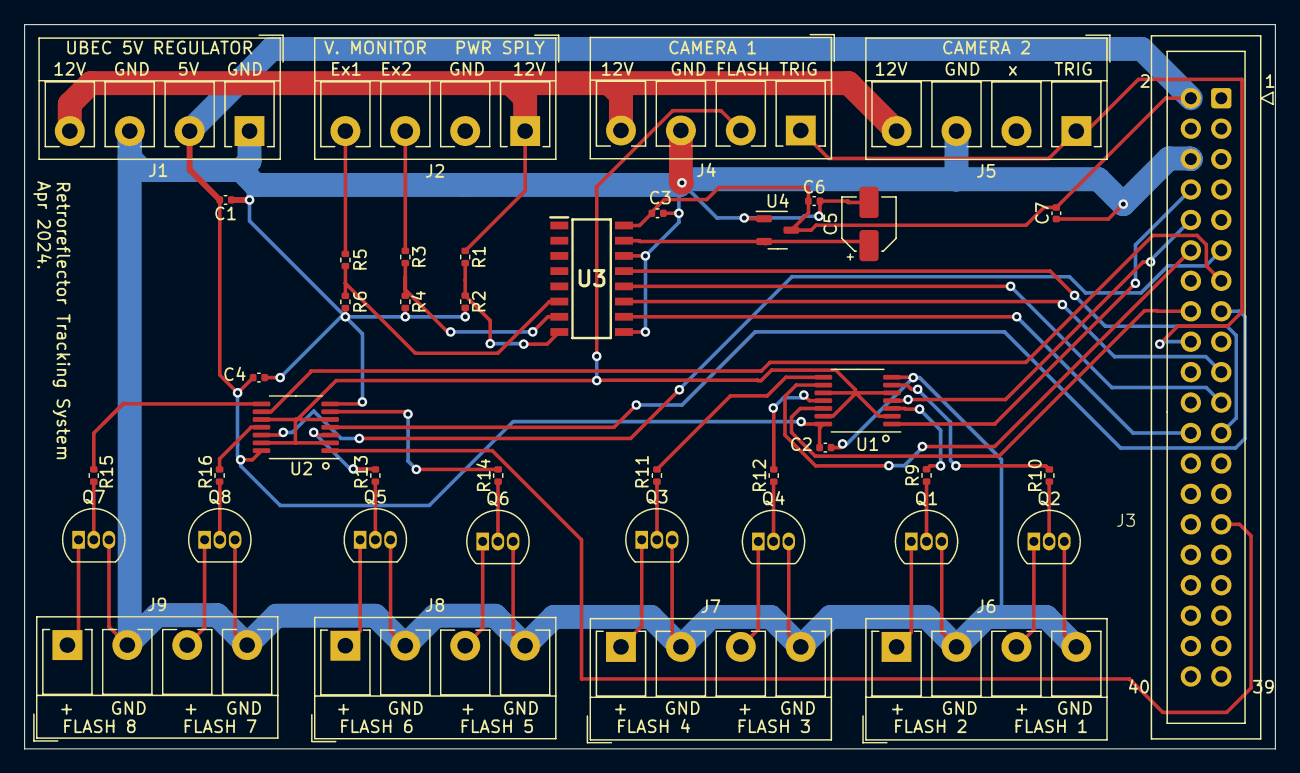
[picture p18: board PCB/pi_hat/pcb.kicad_pcb from above]

Board: 2 copper layers, 104.4 x 60.5 mm, 42 parts (0 on the bottom side), 47 nets.
