SheffieldMLtracking/bee_track_hardware/(commit log)

2024-04-17 Initial commit (send for fab. not tested)
    [BC849CLT1G.stp, EDI2CAP.CFG, PCBWay_BOM.xlsx, chips.prt, pcb.kicad_pcb, pcb.kicad_sch, sot96p237x111-3n.psm]
2024-04-17 Power connections
    [BOM_PCBWay.xlsx, pcb.kicad_pcb, pcb.kicad_sch]
2024-06-18 Dimension fixes and battery holder improvements
2024-06-30 Add files via upload
    Updated 3D files with various changes made by Joe in response to previous test prints 24-30/06/24
2024-08-01 Rename 240712 Back cover.3mf to Orcaslicer project files/240712 Back cover.3mf
    [240712 Back cover.3mf]
2024-08-01 Rename 240712 Side cover #001.3mf to OrcaSlicer project files/240712 Side cover #001.3mf
    [240712 Side cover #001.3mf]
2024-08-01 Rename 240712 Back cover.3mf to 240712 Back cover.3mf
    [240712 Back cover.3mf]
2024-08-01 Rename 240716 Battery stuff for half a box.3mf to OrcaSlicer project files/240716 Battery stuff for half a box.3mf
    [240716 Battery stuff for half a box.3mf]
2024-08-01 Rename 240716 Circuit box.3mf to OrcaSlicer project files/240716 Circuit box.3mf
    [240716 Circuit box.3mf]
2024-08-01 Rename 240716 Main box #001.3mf to OrcaSlicer project files/240716 Main box #001.3mf
    [240716 Main box #001.3mf]
2024-08-01 Rename 240716 Main box #002.3mf to OrcaSlicer project files/240716 Main box #002.3mf
    [240716 Main box #002.3mf]
2024-08-01 Rename 240726 Camera and tripod mounts.3mf to OrcaSlicer project files/240726 Camera and tripod mounts.3mf
    [240726 Camera and tripod mounts.3mf]
2024-08-01 Rename 240801 All small components for 1 box.3mf to OrcaSlicer project files/240801 All small components for 1 box.3mf
    [240801 All small components for 1 box.3mf]
2024-08-01 Rename RetroreflectorCaseTopologyFix.FCStd to FreeCAD design files/RetroreflectorCaseTopology (Chris version).FCStd
    [RetroreflectorCaseTopology (Chris version).FCStd]
2024-08-01 Rename aabattery.FCStd to FreeCAD design files/AA Battery (Mike version).FCStd
    [AA Battery (Mike version).FCStd]
2024-08-01 Rename AA Battery (Mike version).FCStd to AABattery (Mike version).FCStd
    [AABattery (Mike version).FCStd]
2024-08-01 Rename AABatteryJLW2406716.FCStd to AABattery (Joe most recent version 2406716).FCStd
    [AABattery (Joe most recent version 2406716).FCStd]
2024-08-01 Rename RetroreflectorCaseTopologyJLW240801.FCStd to RetroreflectorCaseTopology (Joe most recent version 240801).FCStd
    [RetroreflectorCaseTopology (Joe most recent version 240801).FCStd]
2024-08-01 Rename FreeCAD design files/AA Battery.step to FreeCAD design files/Exported Step files for each component/AA Battery.step
    [AA Battery.step]
